RockTheBike/otw-relay/APPPowerpolePCB.png

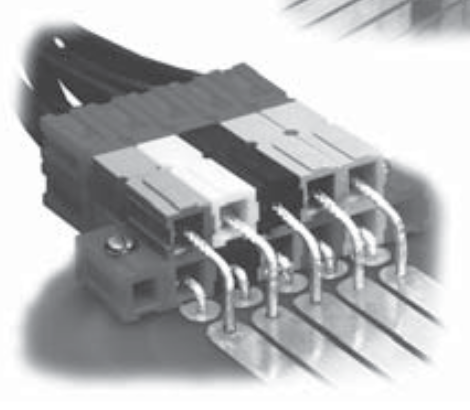
APPPowerpolePCB.png
