RockTheBike/otw-relay/README.md

board
schematic
schematic
