RockTheBike/otw-relay/board.png

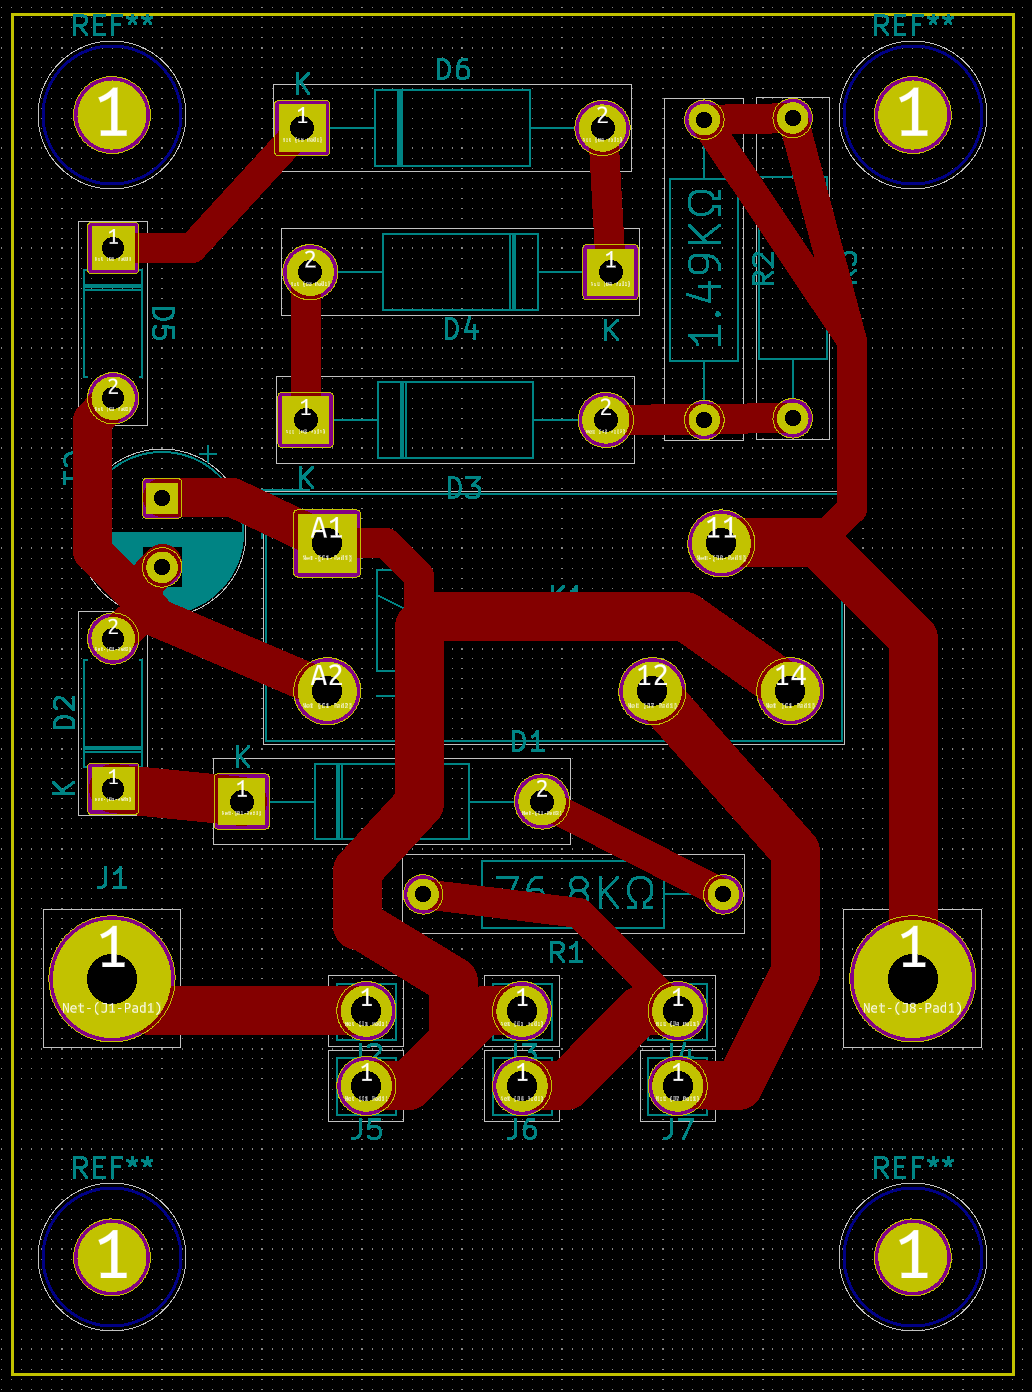
board.png
