RockTheBike/otw-relay/otw-relay-circuit.gif

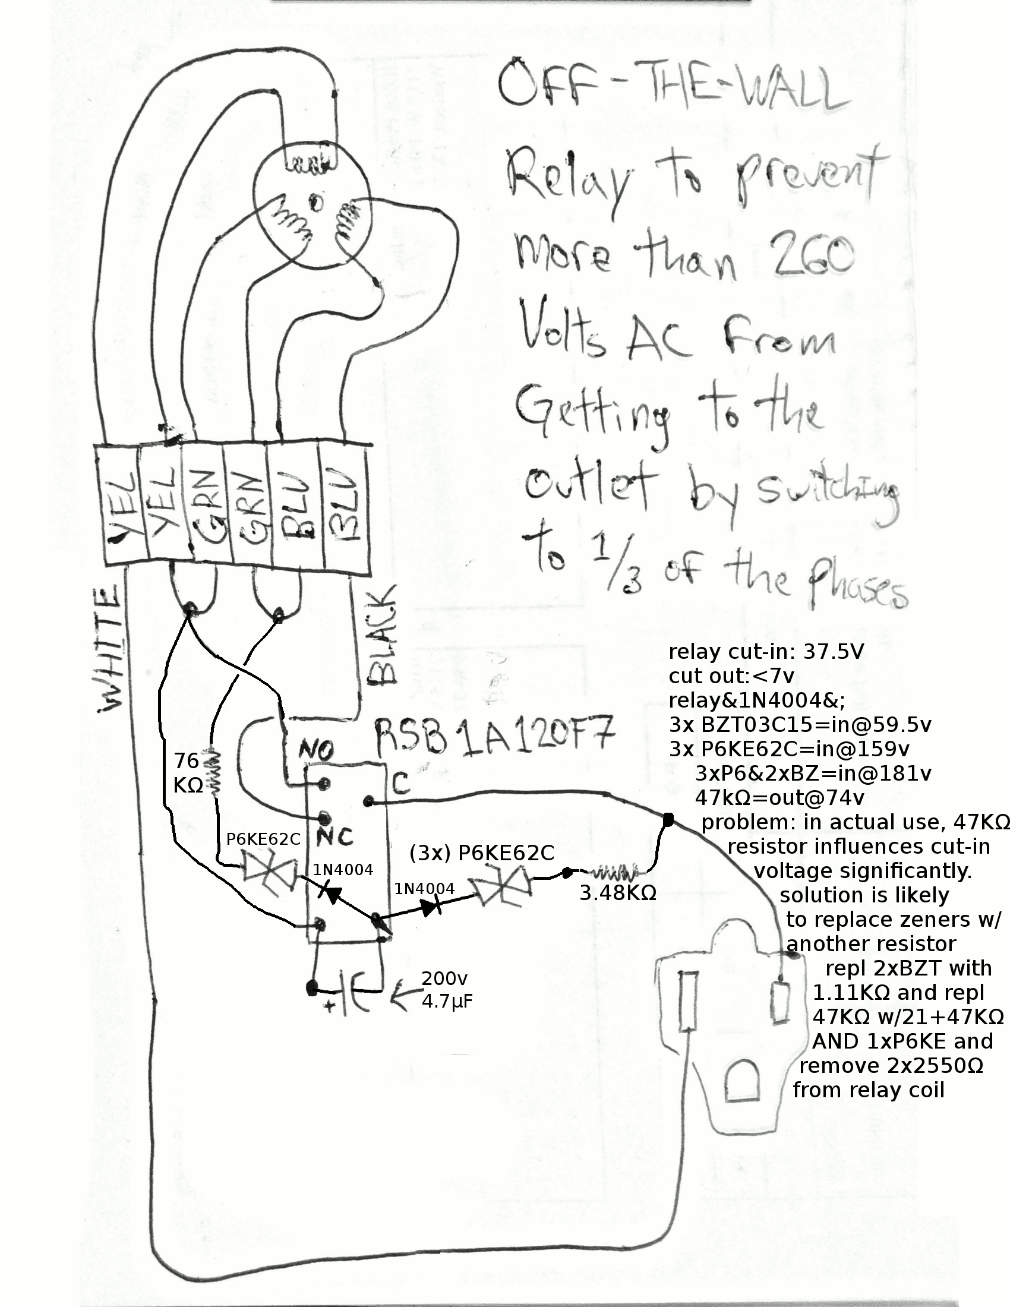
otw-relay-circuit.gif
