RockTheBike/otw-relay/otw-relay.jpg

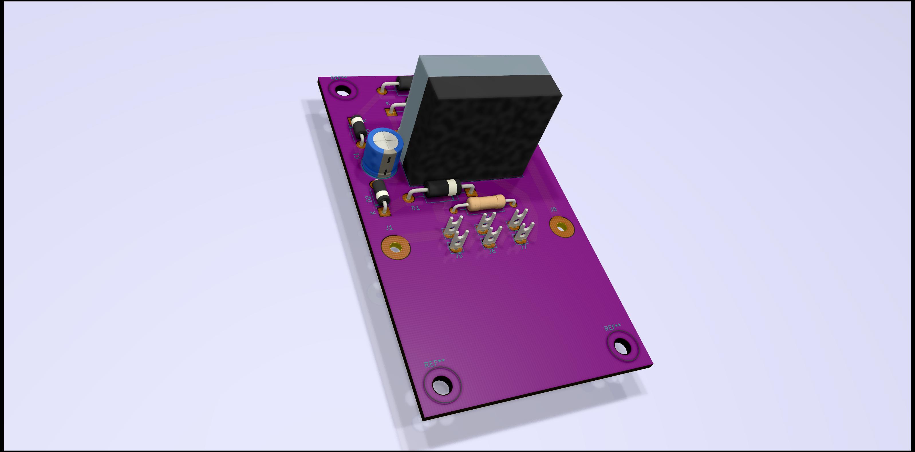
otw-relay.jpg
