RockTheBike/otw-relay/otw-relay.png

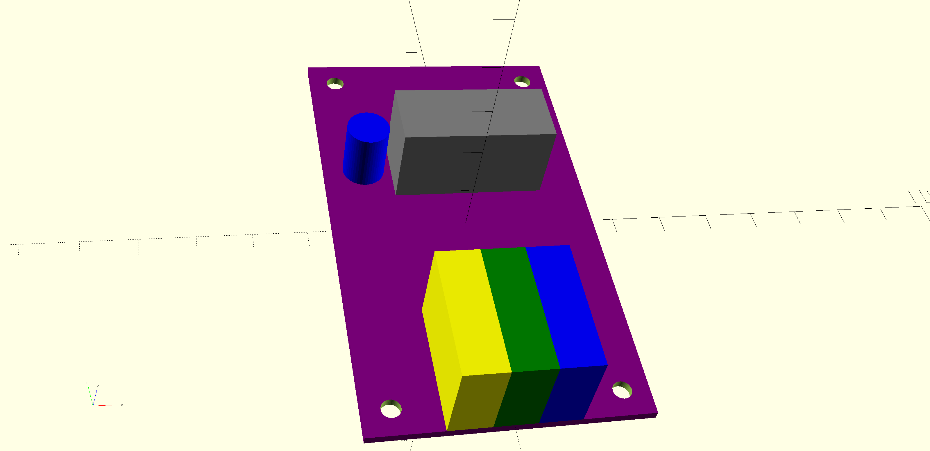
otw-relay.png
