RockTheBike/otw-relay/RSB1A120F7-footprint.gif

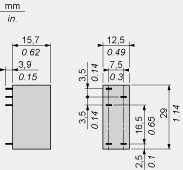
RSB1A120F7-footprint.gif
