RockTheBike/otw-relay/schematic.png

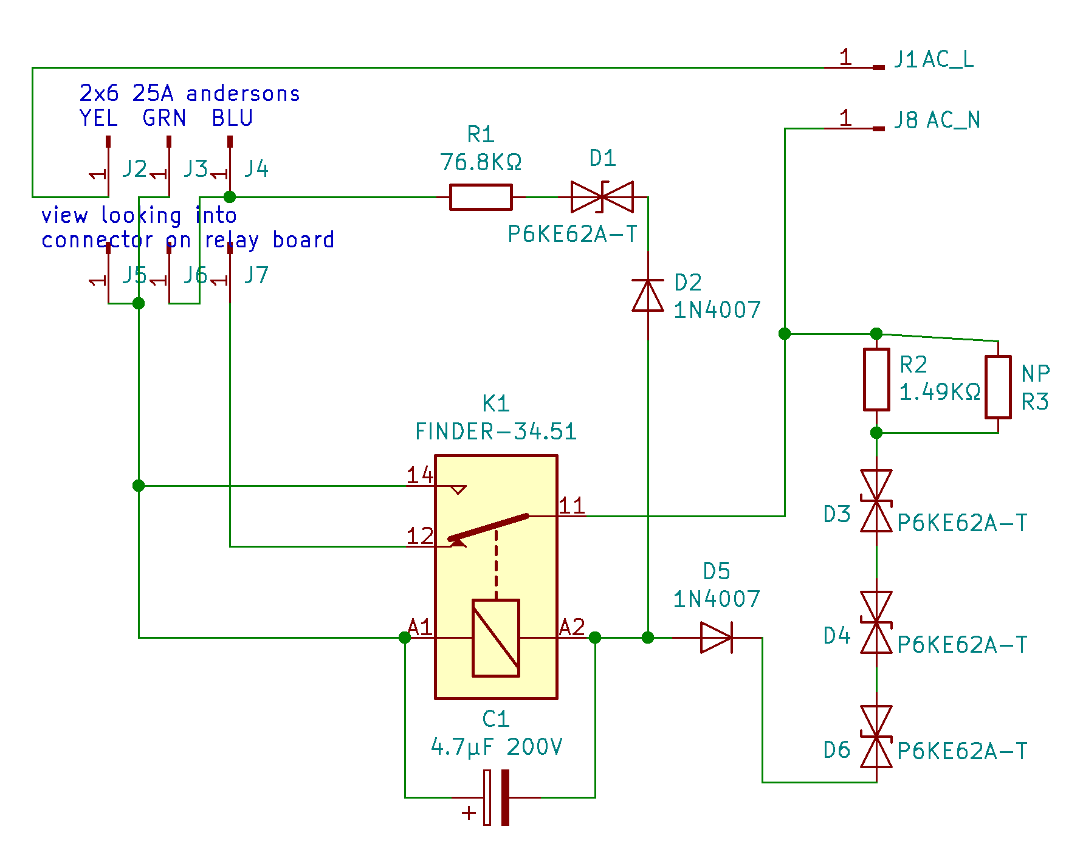
schematic.png
