RockTheBike/otw-relay/otw-relay.stl

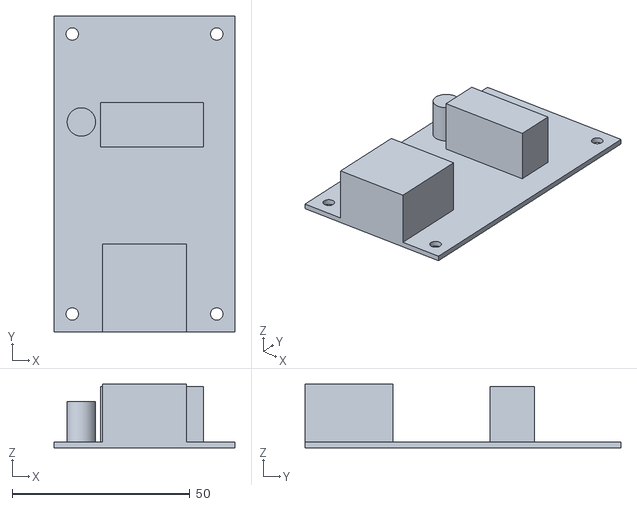
[picture p8: CAD file, 2019-02-19]
otw-relay.stl
50.8 x 88.9 x 17.9
