RockTheBike/otw-relay/(commit log)

2019-02-12 first commit of schematic
    [otw-relay.kicad_pcb, otw-relay.sch]
2019-02-12 relay datasheet and other info
2019-02-12 add schematic and eeschematic
2019-02-12 finish laying out eeschematic
    [otw-relay.sch]
2019-02-13 pick footprints and start laying out, add boardpic
    [otw-relay.kicad_pcb, otw-relay.sch]
2019-02-13 change AC out to two wire holes
    [otw-relay.kicad_pcb, otw-relay.sch]
2019-02-14 update images but not boardfiles
2019-02-14 finish board layout with mounting holes
    [otw-relay.kicad_pcb, otw-relay.sch]
2019-02-16 create 3d model using openscad
    [otw-relay.scad, otw-relay.stl]
2019-02-16 3d view generated by KiCAD
2019-02-16 raytraced 3d view generated by KiCAD
2019-02-19 3D model: fix screw locations, add capacitor and relay
    [otw-relay.scad, otw-relay.stl]
2019-03-14 IMPORTANT fix hole sizes for Anderson connectors to fit
    [otw-relay.kicad_pcb]
2019-03-14 remove otw-relay.bak
2019-03-14 fix TVS directions, add resistor vals to silk
    [otw-relay.kicad_pcb, otw-relay.sch]
2019-03-14 update board image
2020-06-23 move mounting holes to 58mm, add R3
    [otw-relay.kicad_pcb, otw-relay.sch]
2020-06-23 update images of schematic and board
2020-06-28 add R3 resistor spot
    [otw-relay.kicad_pcb]
